adafruit/Adafruit-RS-232-Level-Shifter-Breakout-PCB/Adafruit RS-232 Full Pinout Level-Shifter Breakout.brd

## EAGLE design Adafruit RS-232 Full Pinout Level-Shifter Breakout.brd (2024-08-12)

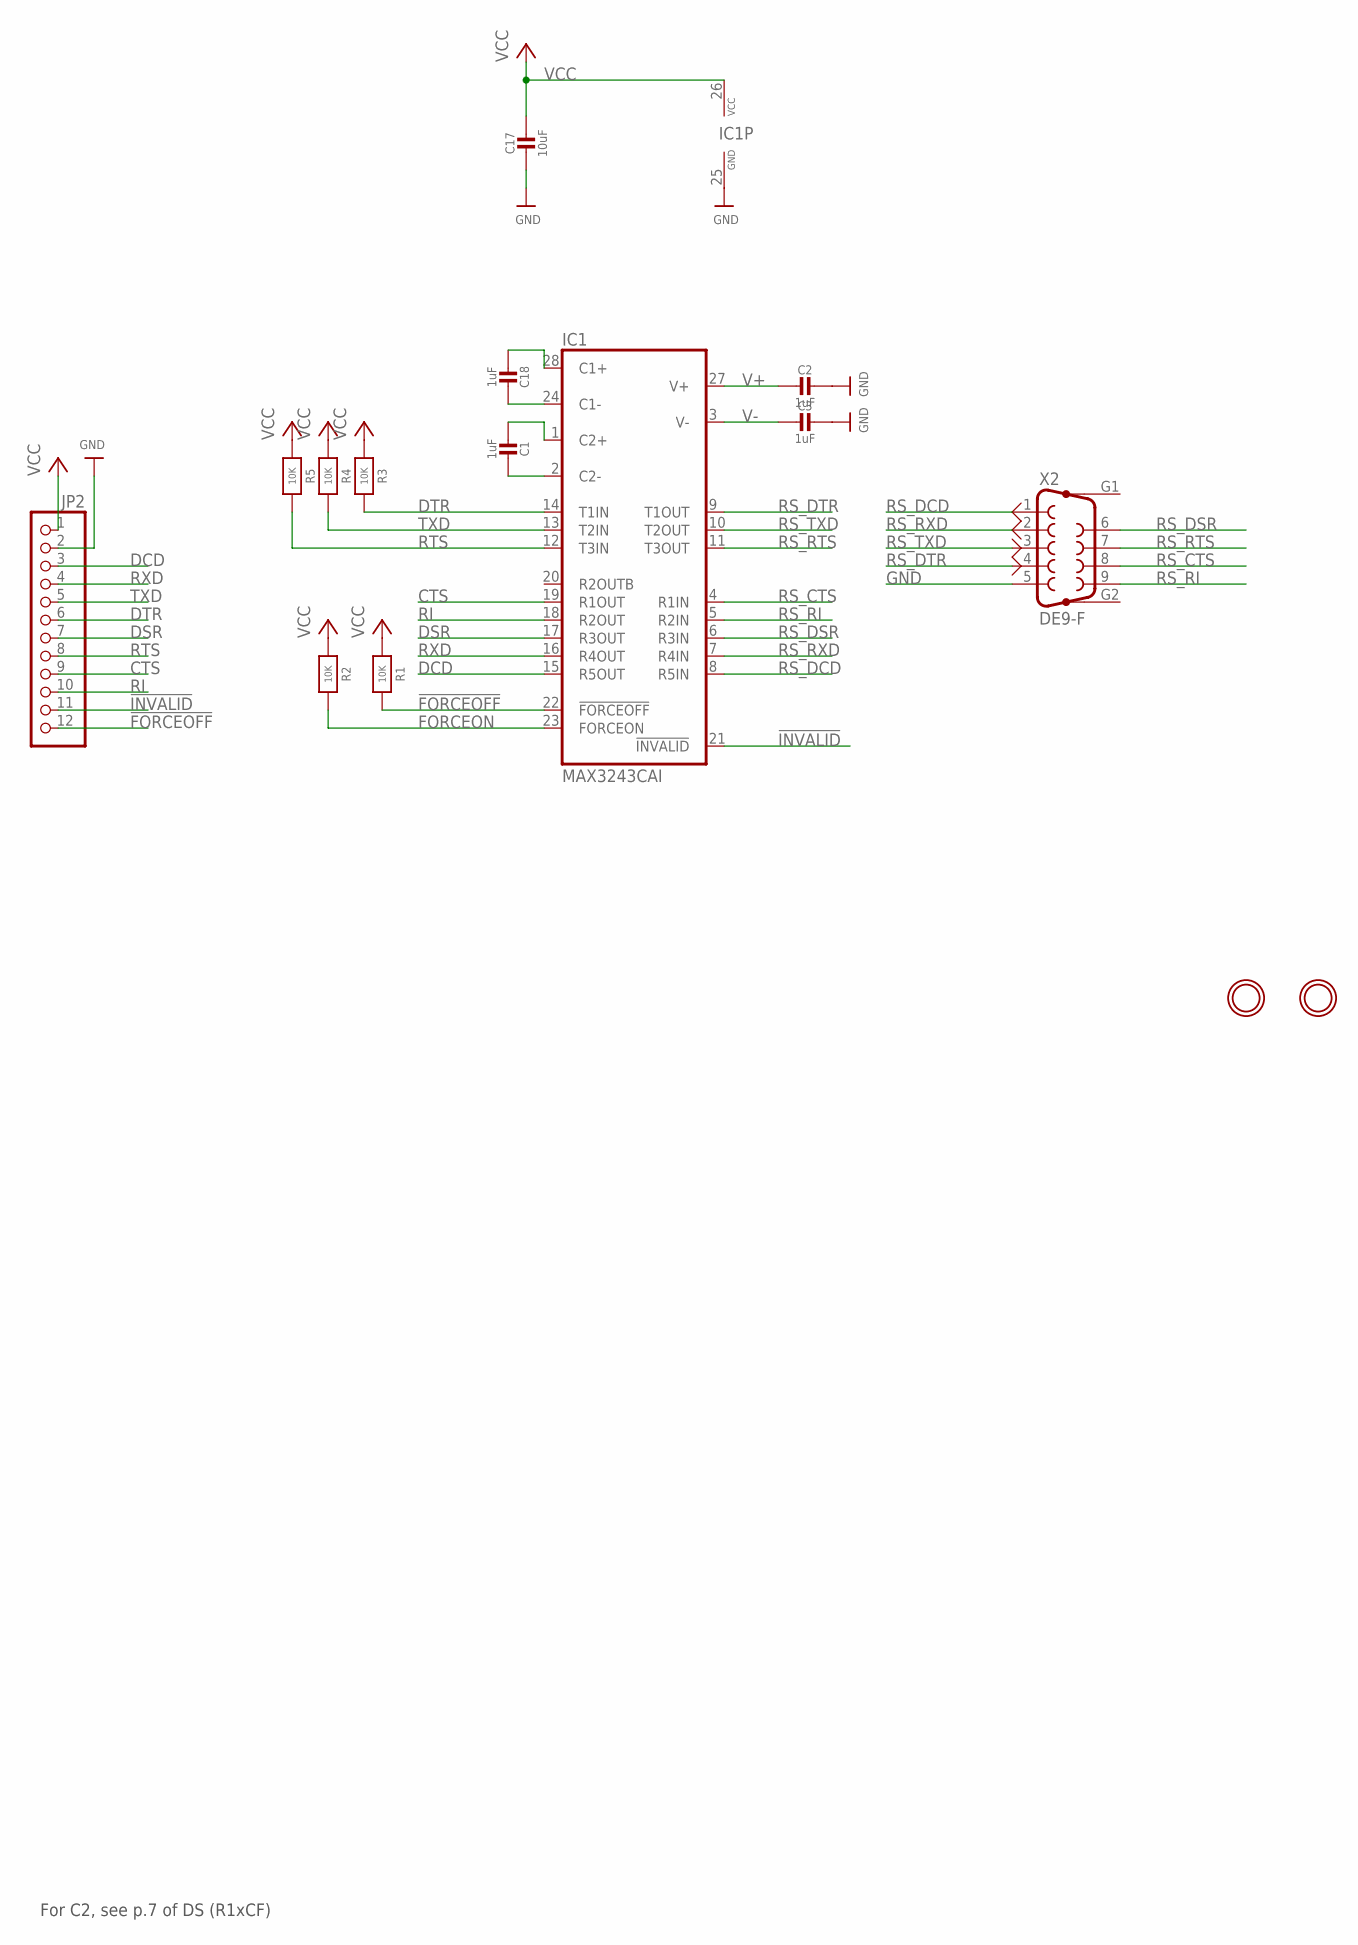
[picture p2: schematic Adafruit RS-232 Full Pinout Level-Shifter Breakout.sch]

Parts:
C1, C2, C3, C18: 1uF; 0603-NO
C17: 10uF; 0805-NO
IC1: MAX3243CAI; SSOP28
JP2: HEADER-1X1276MIL; 1X12_ROUND_76MIL
R1, R2, R3, R4, R5: 10K; 0603-NO
U$2, U$3: MOUNTINGHOLE3.0THIN; MOUNTINGHOLE_3.0_PLATEDTHIN
X2: DE9-F; F09HP

Connections:
!FORCEOFF: IC1.22 (!FORCEOFF), JP2.12, R1.2
!INVALID: IC1.21 (!INVALID), JP2.11
CTS: IC1.19 (R1OUT), JP2.9
DCD: IC1.15 (R5OUT), JP2.3
DSR: IC1.17 (R3OUT), JP2.7
DTR: IC1.14 (T1IN), JP2.6, R3.2
FORCEON: IC1.23 (FORCEON), R2.2
GND: C2.1, C3.1, C17.2, IC1.25 (GND), JP2.2, X2.5
unnamed: C18.2, IC1.28 (C1+)
unnamed: C18.1, IC1.24 (C1-)
unnamed: C1.1, IC1.2 (C2-)
unnamed: C1.2, IC1.1 (C2+)
RI: IC1.18 (R2OUT), JP2.10
RS_CTS: IC1.4 (R1IN), X2.8
RS_DCD: IC1.8 (R5IN), X2.1
RS_DSR: IC1.6 (R3IN), X2.6
RS_DTR: IC1.9 (T1OUT), X2.4
RS_RI: IC1.5 (R2IN), X2.9
RS_RTS: IC1.11 (T3OUT), X2.7
RS_RXD: IC1.7 (R4IN), X2.2
RS_TXD: IC1.10 (T2OUT), X2.3
RTS: IC1.12 (T3IN), JP2.8, R5.2
RXD: IC1.16 (R4OUT), JP2.4
TXD: IC1.13 (T2IN), JP2.5, R4.2
V+: C2.2, IC1.27 (V+)
V-: C3.2, IC1.3 (V-)
VCC: C17.1, IC1.26 (VCC), JP2.1, R1.1, R2.1, R3.1, R4.1, R5.1

Notes on the sheet:
For C2, see p.7 of DS (R1xCF)

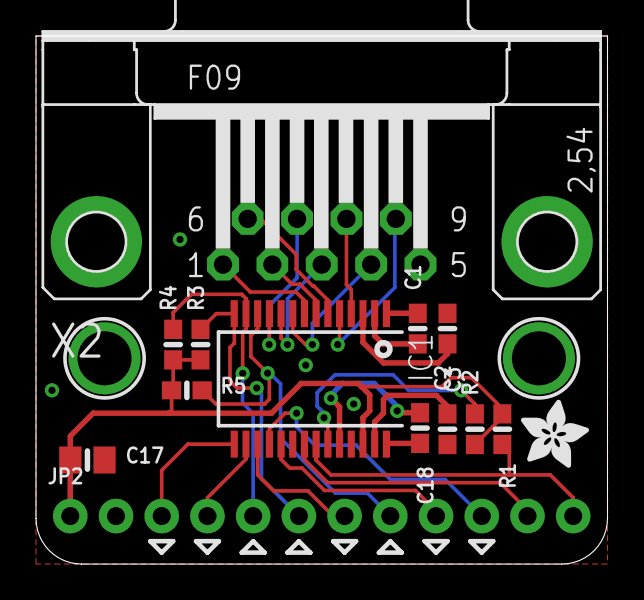
[picture p3: board Adafruit RS-232 Full Pinout Level-Shifter Breakout.brd from above]

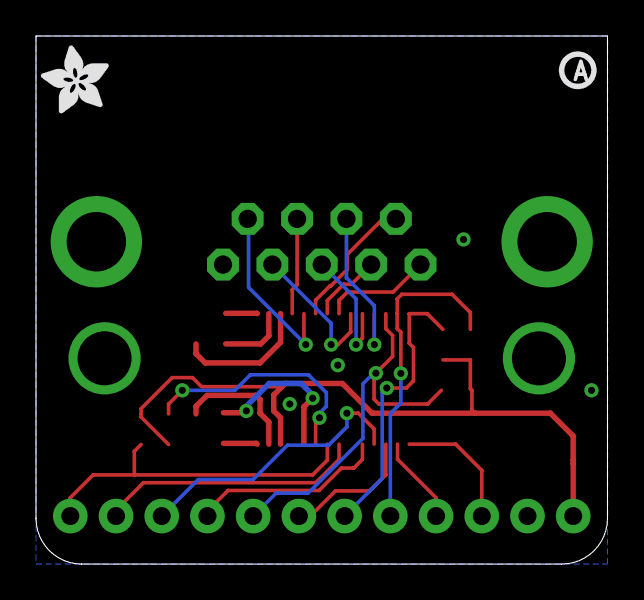
[picture p4: board Adafruit RS-232 Full Pinout Level-Shifter Breakout.brd from below]

Board: 2 copper layers, 31.8 x 29.3 mm, 34 parts (5 on the bottom side), 27 nets.

Other parts of the board:
PLABEL0: PLABEL0
PLABEL1: PLABEL1
PLABEL2: PLABEL2
PLABEL3: PLABEL3
PLABEL4: PLABEL4
PLABEL5: PLABEL5
PLABEL6: PLABEL6
PLABEL7: PLABEL7
PLABEL8: PLABEL8
PLABEL9: PLABEL9
PLABEL10: PLABEL10
PLABEL11: PLABEL11
PLABEL12: PLABEL12
PLABEL13: PLABEL13
PLABEL14: PLABEL14
PLABEL15: PLABEL15
U$5: PCBFEAT-REV-040
U$8, U$9: ADAFRUIT_3.5MM
